legalaspro/fastbot_ros2/docs/README.md

# Fastbot Documentation

This directory contains documentation for building, configuring, and using the Fastbot robot.

## Contents

### [Build Guide](build_guide/)

Step-by-step guide documenting the evolution of the Fastbot robot build:

### [Hardware](hardware/)

Physical components and fabrication files:

- **[Cover](hardware/cover/)** - Optional decorative cover with 3D printing files

## Quick Links

- [Main Repository README](../README.md)
- [Robot Description Package](../fastbot_description/)
- [Bringup Package](../fastbot_bringup/)
