legalaspro/fastbot_ros2/docs/hardware/cover/robot-cover-1.1.3mf

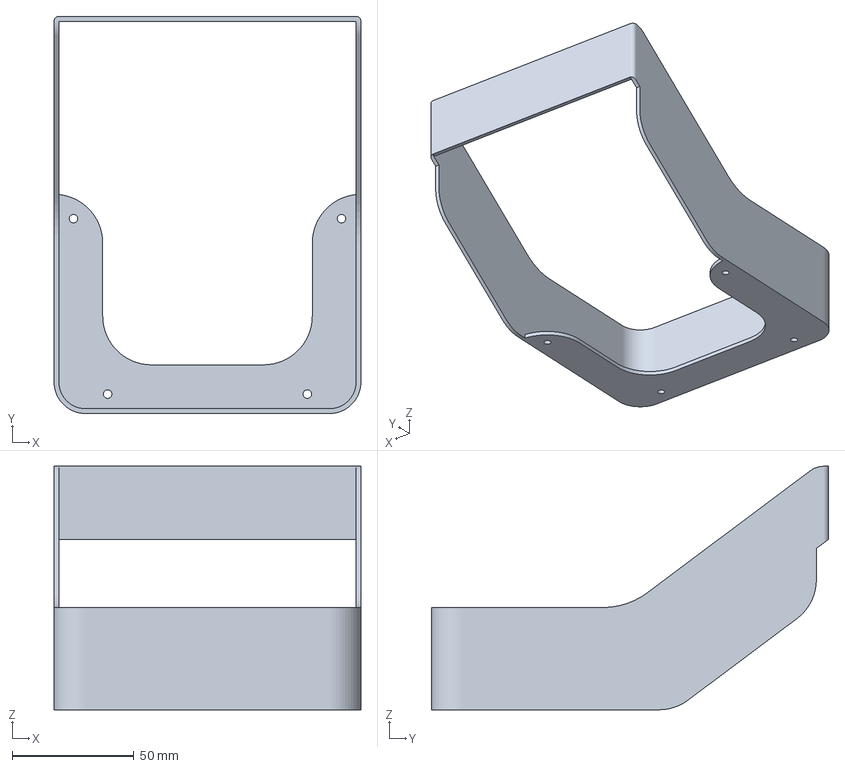
[picture p8: CAD file, 2025-12-22]
docs/hardware/cover/robot-cover-1.1.3mf
126.0 x 163.0 x 100.0 mm
