legalaspro/fastbot_ros2/fastbot_description/onshape/assets/wheel_d65x25_v1.stl

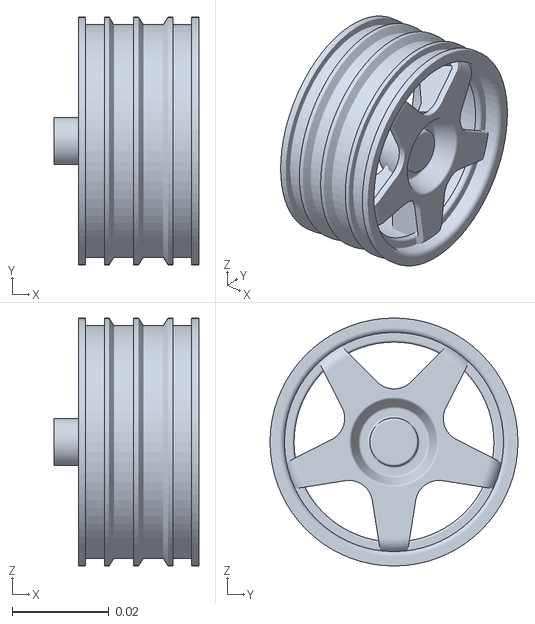
[picture p9: CAD file, 2025-12-21]
fastbot_description/onshape/assets/wheel_d65x25_v1.stl
0.03 x 0.0514 x 0.0514
