legalaspro/fastbot_ros2/fastbot_description/onshape/assets/fastbot_motor.stl

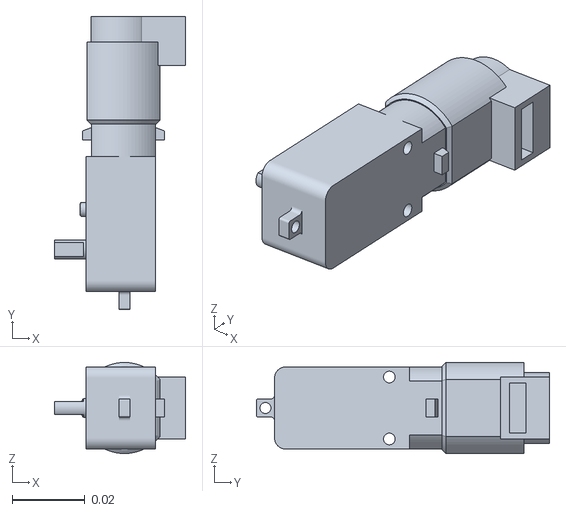
[picture p10: CAD file, 2025-12-21]
fastbot_description/onshape/assets/fastbot_motor.stl
0.036 x 0.0805 x 0.025
