legalaspro/fastbot_ros2/fastbot_description/onshape/assets/raspicam.stl

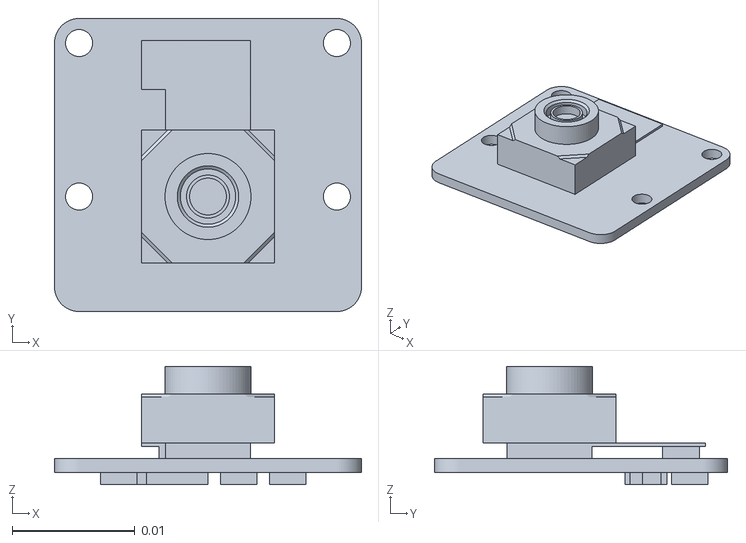
[picture p11: CAD file, 2025-12-21]
fastbot_description/onshape/assets/raspicam.stl
0.025 x 0.0239 x 0.00962
