legalaspro/fastbot_ros2/fastbot_description/onshape/assets/pololu_ball_caster.stl

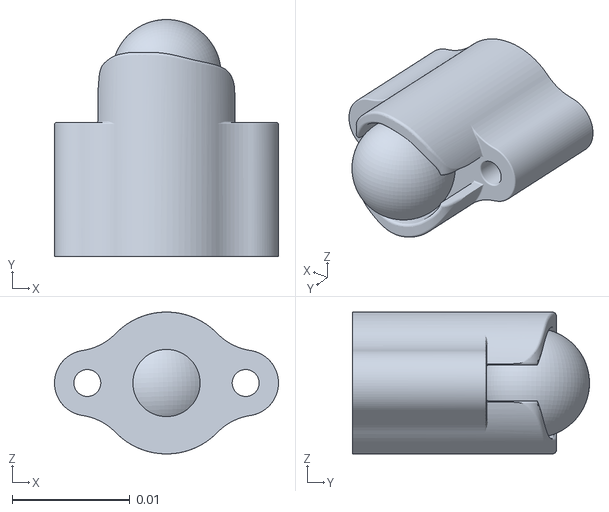
[picture p12: CAD file, 2025-12-21]
fastbot_description/onshape/assets/pololu_ball_caster.stl
0.0191 x 0.0202 x 0.0121
