legalaspro/fastbot_ros2/fastbot_description/onshape/assets/lslidar_n10.stl

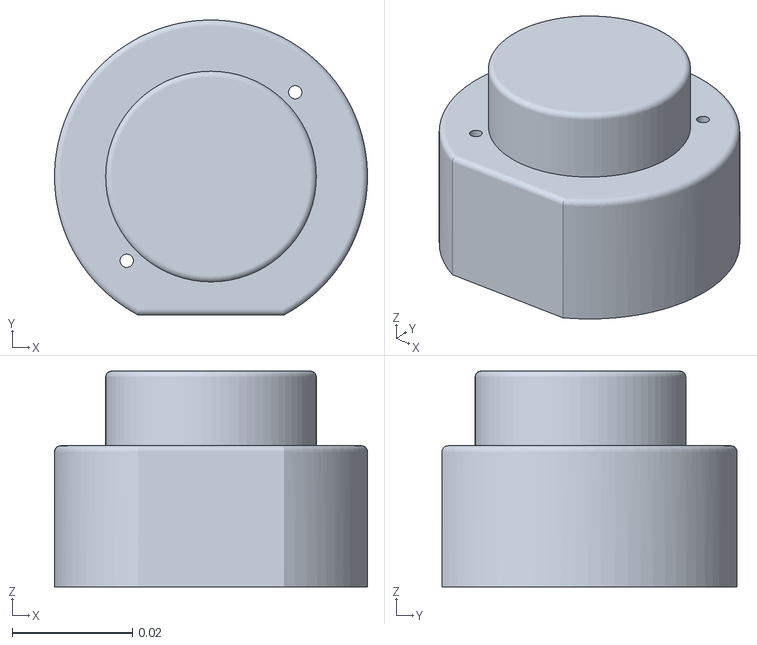
[picture p13: CAD file, 2025-12-21]
fastbot_description/onshape/assets/lslidar_n10.stl
0.052 x 0.049 x 0.0359
