legalaspro/fastbot_ros2/fastbot_description/onshape/assets/tire_d65x25_v1.stl

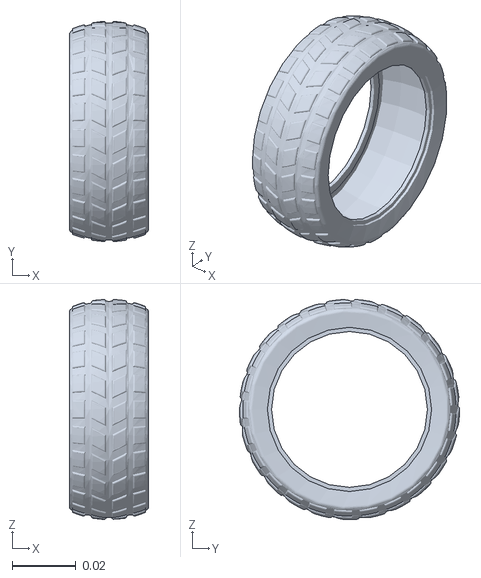
[picture p14: CAD file, 2025-12-21]
fastbot_description/onshape/assets/tire_d65x25_v1.stl
0.0248 x 0.0689 x 0.0689
