legalaspro/fastbot_ros2/fastbot_description/onshape/assets/base_link.stl

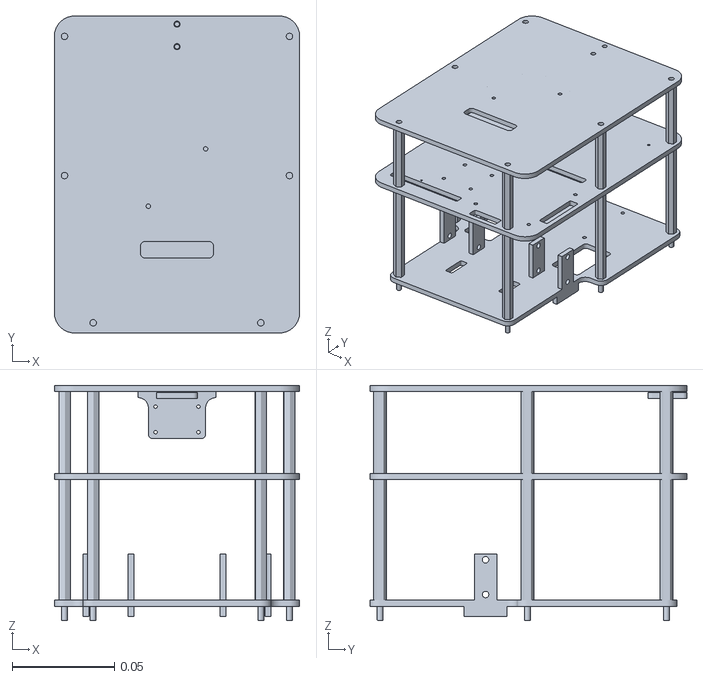
[picture p15: CAD file, 2025-12-21]
fastbot_description/onshape/assets/base_link.stl
0.12 x 0.155 x 0.115
