legalaspro/fastbot_ros2/(commit log)

2025-12-21 Initial commit: FastBot ROS 2 project
    [base_link.stl, fastbot_body.xacro, fastbot_motor.stl, fastbot_multi_sim.xacro, lslidar_n10.stl, model.sdf, pololu_ball_caster.stl, raspicam.stl]
2025-12-22 Added docs for the fastbot
    [robot-cover-1.1.3mf]
2025-12-22 Small edit in serial motor launch
2025-12-22 Added fix frame for the robot on bringup launch.
2025-12-22 Added joint states publishing for the robot
2025-12-22 fixed visual for the lslidar
    [fastbot_body.xacro]
